WNoxchi/flight-controller/specs/usb-c.md

# Spec: USB-C Interface

## Overview
USB 2.0 Full-Speed device-only (UFP/sink) for DFU flashing and Betaflight configurator.

## Connections
- USB_DM: PA11, USB_DP: PA12
- STM32F405 has internal 1.5kΩ pull-up on D+ (no external needed)

## Circuit
- USB-C connector: 12-pin (HRO TYPE-C-31-M-12), 4 THT mounting tabs + SMD signal pads
- 2x 5.1kΩ resistors on CC1, CC2 to GND (UFP/sink identification)
- ESD protection: USBLC6-2SC6 (ST) dual-line TVS on D+/D-
- 22Ω series resistors on D+ and D- (impedance matching)
- Schottky diode (SS34) from VBUS to 5V rail (power OR with BEC)
- Shield to GND via 1MΩ ∥ 4.7nF

## Assert Constraints
```
# CC1/CC2 sink resistors (USB-C spec requires 5.1k for UFP identification)
assert r_cc1.value within 4.9kohm to 5.3kohm
assert r_cc2.value within 4.9kohm to 5.3kohm

# D+/D- series resistors (USB 2.0 impedance matching)
assert r_dp.value within 20ohm to 24ohm
assert r_dm.value within 20ohm to 24ohm

# VBUS decoupling after Schottky
assert c_vbus.value within 4.0uF to 5.5uF
```

## NDAA
- USBLC6-2SC6: STMicroelectronics (Franco-Italian, clean)
- HRO connector: Korean company (Hroparts Elec, clean)
