WNoxchi/flight-controller/layouts/default/default.kicad_pcb

## KiCad design layouts/default/default.kicad_pcb (2026-03-06)

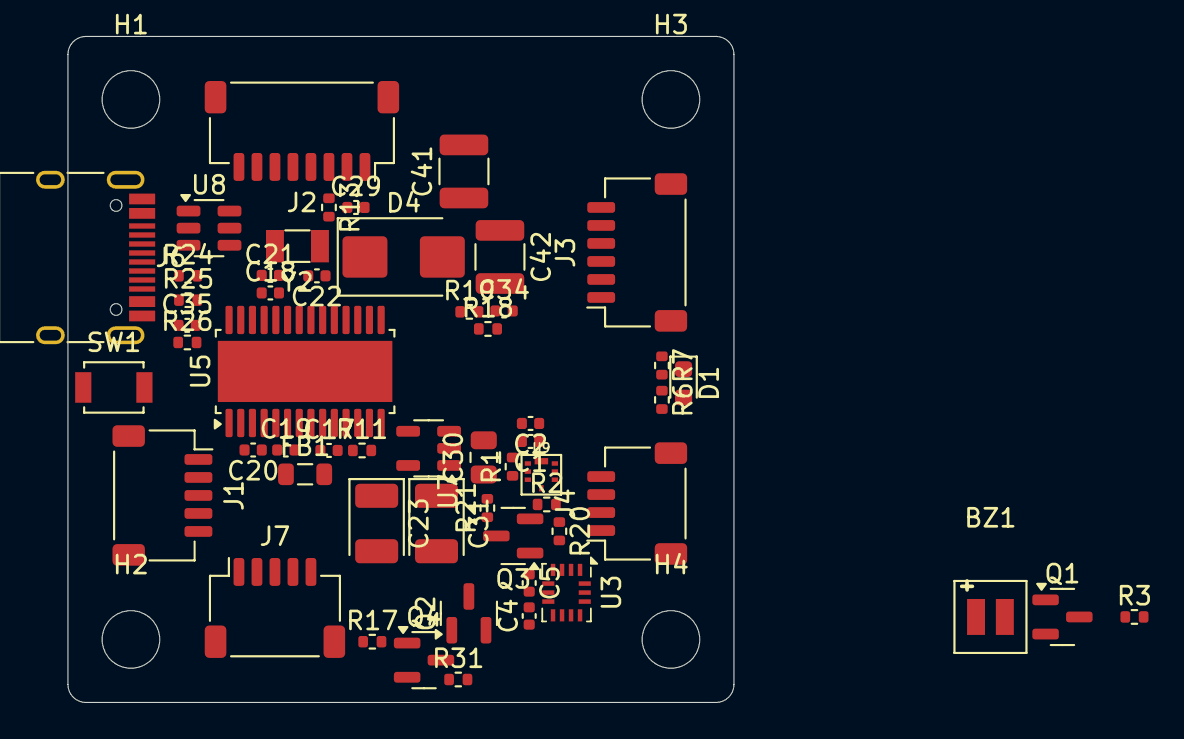
[picture p1: board default.kicad_pcb from above]

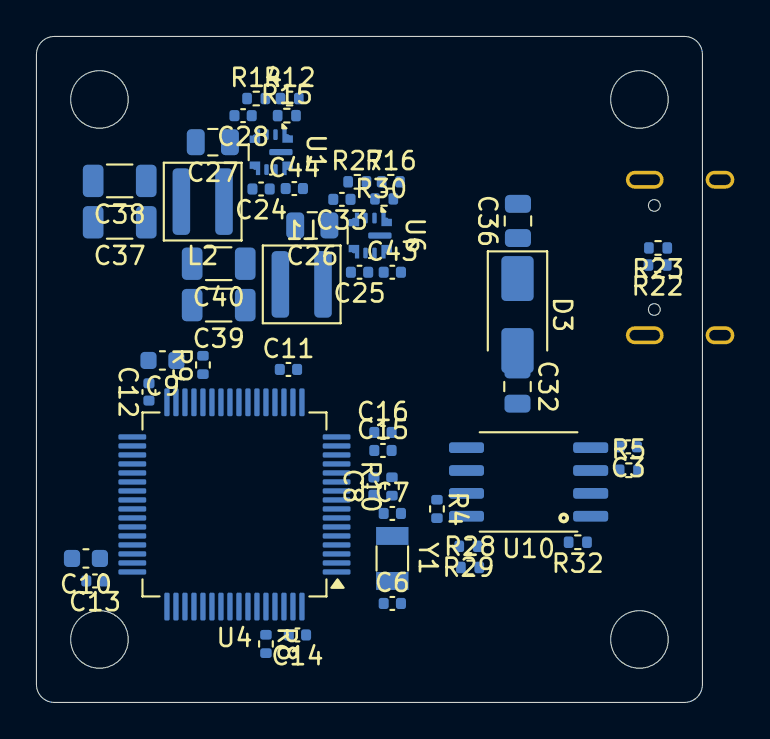
[picture p2: board default.kicad_pcb from below]

Board: 2 copper layers, 37.0 x 37.0 mm, 109 parts (50 on the bottom side), 83 nets, no tracks yet.

Parts:
BZ1: Buzzer_SMD_CMT-4023S_4x4mm
C1, C2, C3, C4, C5, C6, C7, C8, C11, C12, C13, C14, C15, C16, C17, C18, C19, C20, C21, C22, C24, C25, C28, C29, C33, C34, C35, C43, C44: C_0402_1005Metric
C9, C10: C_0603_1608Metric
C23, C31: CP_EIA-3528-21_Kemet-B
C26, C27, C30, C32, C36: C_0805_2012Metric
C37, C38, C39, C40: C_1206_3216Metric
C41, C42: C_1210_3225Metric
D1: LED_0603_1608Metric
D3: D_SMA
D4: D_SMB
FB1: L_0805_2012Metric
H1, H2, H3, H4: MountingHole_3.2mm_M3
J1, J7: JST_SH_SM05B-SRSS-TB_1x05-1MP_P1.00mm_Horizontal
J2: JST_SH_SM08B-SRSS-TB_1x08-1MP_P1.00mm_Horizontal
J3: JST_SH_SM06B-SRSS-TB_1x06-1MP_P1.00mm_Horizontal
J4: JST_SH_SM04B-SRSS-TB_1x04-1MP_P1.00mm_Horizontal
J6: USB_C_Receptacle_HRO_TYPE-C-31-M-12
L1, L2: L_Wuerth_MAPI-4020
Q1, Q2, Q3, Q4: SOT-23
R1, R2, R3, R4, R5, R6, R7, R8, R9, R10, R11, R12, R13, R14, R15, R16, R17, R18, R19, R20, R21, R22, R23, R24, R25, R26, R27, R28, R29, R30, R31, R32: R_0402_1005Metric
SW1: SW_SPST_B3U-1000P
U1, U6: TI_RPE0009B_VQFN-HR-9_2x2mm_P0.5mm
U3: Bosch_LGA-14_3x2.5mm_P0.5mm
U4: LQFP-64_10x10mm_P0.5mm
U5: TSSOP-28-1EP_4.4x9.7mm_P0.65mm_EP3.4x9.7mm_Mask3.1x4.05mm
U7: SOT-23-5
U8: SOT-23-6
U9: Bosch_LGA-10_2x2mm_P0.275x0.250mm
U10: SOIC-8_5.23x5.23mm_P1.27mm
Y1, Y2: Crystal_SMD_3215-2Pin_3.2x1.5mm

Connections:
A5: J6.A5, R22.1
B5: J6.B5, R23.1
adc_curr: C29.1, R13.2, U4.9
adc_vbat: C34.1, R18.1, R19.2, U4.10
anode: D1.2, R6.2
avdd: C17.1, FB1.2, U5.9
baro-gnd: C1.2, C2.2, C3.2, C4.2, C5.2, C17.2, C18.2, C19.2, C21.2, C22.2, C23.2, C26.2, C27.2, C28.2, C29.2, C30.2, C31.2, C32.2, C33.2, C34.2, C35.2, C36.2, C37.2, C38.2, C39.2, C40.2, C41.2, C42.2, C43.2, C44.2, D4.1, J1.1, J1.5, J2.1, J3.1, J4.1, J6.A1, J6.A12, J6.B1, J6.B12, J7.2, Q1.2, Q3.2, Q4.2, R12.2, R16.2, R18.2, R22.2, R23.2, R26.2, R28.2, R32.2, U1.9, U3.6, U3.7, U5.6, U5.10, U5.24, U5.29, U6.1, U6.9, U7.2, U8.3, U9.3, U9.8, U9.9, U10.4
baro-vdd: C1.1, C2.1, C3.1, C4.1, C5.1, C11.1, C12.1, C13.1, C14.1, C15.1, C16.1, C18.1, C19.1, C23.1, C31.1, FB1.1, R1.2, R2.2, R4.2, R5.2, R6.1, R10.2, R11.2, R21.2, SW1.2, U3.5, U3.8, U4.1, U4.13, U4.19, U4.32, U4.48, U4.64, U5.5, U5.25, U7.5, U9.1, U9.5, U9.6, U9.10, U10.8
beeper-drain: BZ1.2, Q1.3
beeper-gate: Q1.1, R3.2
beeper-gpio: R3.1, U4.27
beeper-vdd: BZ1.1, C30.1, C32.1, C39.1, C40.1, D3.2, J1.2, J3.2, J4.2, L1.2, R30.2, U6.8, U7.1, U7.3
boot0: R8.1, SW1.1, U4.60
buck-boot: C25.1, U6.6
buck-en: R16.1, R27.2, U6.3
buck-pgood: R30.1, U6.2
buck-sw: C25.2, L1.1, U6.5
buck-vcc: C43.1, U6.7
buck_vtx-boot: C24.1, U1.6
buck_vtx-en: R12.1, R14.2, U1.3
buck_vtx-pgood: R15.1, U1.2
buck_vtx-sw: C24.2, L2.1, U1.5
buck_vtx-vcc: C44.1, U1.7
c_hse1-gnd: C6.2, C7.2, C8.2, C9.2, C10.2, C11.2, C12.2, C13.2, C14.2, C15.2, C16.2, R8.2, R9.2, U4.12, U4.18, U4.63
c_sag-video_in: C20.2, J7.3, U5.3
cam_conn-video_in: J1.3, U5.8
cam_ctrl: J1.4, U4.55
clkin: C21.1, U5.23, Y2.1
conn-rx-0: J3.4, U4.17
conn-rx-1: J4.3, R20.1
conn-tx-0: J3.3, U4.16
conn-tx-1: J4.4, U4.42
conn-uart_rx: J7.4, U4.54
conn_dm: J6.A7, J6.B7, R24.1, U8.1, U8.2
conn_dp: J6.A6, J6.B6, R25.1, U8.5, U8.6
curr: J2.3, R13.1
data: R7.1, U4.58
dm: R24.2, U4.44
dp: R25.2, U4.45
exti: U3.4, U4.25
fb: R28.1, R29.2, U1.8
flash-cs: U4.59, U10.1
flash-spi_miso: U4.52, U10.2
flash-spi_mosi: U4.57, U10.5
flash-spi_sck: U4.51, U10.6
footprint-cs-0: U3.12, U4.24
footprint-cs-1: U4.33, U5.20
footprint-drain: Q2.1, Q4.3, R31.1
footprint-gate-0: Q4.1, R17.2
footprint-gate-1: Q3.1, R20.2
footprint-gpio-0: D1.1, U4.26
footprint-spi_miso-0: U3.1, U4.22
footprint-spi_miso-1: U4.35, U5.17
footprint-spi_mosi-0: U3.14, U4.23
footprint-spi_mosi-1: U4.36, U5.19
footprint-spi_sck-0: U3.13, U4.21
footprint-spi_sck-1: U4.34, U5.18
footprint-uart_rx: Q3.3, R21.1, U4.43
hold: R4.1, U10.7
nrst: C8.1, R10.1, U4.7
pb2: R9.1, R17.1, U4.28
pc6: J2.4, U4.37
pc7: J2.5, U4.38
pc8: J2.6, U4.39
pc9: J2.7, U4.40
rail_10v_vtx: C37.1, C38.1, L2.2, Q2.2, R15.2, R29.1, R31.2
reset: R11.1, U5.11
rt: R32.1, U1.1
sag: C20.1, U5.4
scl: J3.5, R1.1, U4.61, U9.2
sda: J3.6, R2.1, U4.62, U9.4
shield: C35.1, J6.S1, R26.1
telem: J2.8, U4.15
uart_tx: J7.5, U4.53
vbat: C26.1, C27.1, C28.1, C33.1, C41.1, C42.1, D4.2, J2.2, R14.1, R19.1, R27.1, U1.4, U6.4
vbus: C36.1, D3.1, J6.A4, J6.A9, J6.B4, J6.B9, U8.4
vcap1: C9.1, U4.31
vcap2: C10.1, U4.47
vtx_10v: J7.1, Q2.3
wp: R5.1, U10.3
xfb: C22.1, U5.22, Y2.2
xin: C6.1, U4.5, Y1.1
xout: C7.1, U4.6, Y1.2
