WNoxchi/flight-controller/(commit log)

2026-03-01 TASK-001: Implement MCU core component (STM32F405RGT6)
    Full implementation of the MCU core module with all support circuits:
    - Custom STM32F405RGT6 component definition with verified LQFP-64 pinout
    (64 pins mapped against DS8597 Rev 9 datasheet)
    - 8MHz HSE crystal oscillator (ABM8-8.000MHZ-B2-T) with 20pF load caps
    - VCAP1/VCAP2 internal regulator caps (2.2uF ceramic)
    - Per-VDD decoupling (4x 100nF, one per VDD pin)
    - VDDA analog supply filtering (1uF bulk + 100nF bypass)
    - BOOT0 circuit (10k pulldown + tactile switch to 3.3V for DFU)
    - NRST circuit (10k pullup + 100nF debounce + tactile switch)
    - PB2/BOOT1 mandatory 10k pulldown (SRAM boot trap prevention)
    - SWD debug signals (PA13/PA14)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
2026-03-01 TASK-002: Implement power distribution system (MP1584EN buck + AMS1117 LDO)
    Complete power subsystem with 20 components and 5 passing assertions:
    - MP1584EN SOIC-8 buck converter (VBAT→5V/3A) with feedback divider,
    compensation network, bootstrap cap, inductor, and catch diode
    - AMS1117-3.3 SOT-223 LDO (5V→3.3V) with tantalum output cap
    - VBAT input protection: SMBJ26A TVS + 100uF bulk cap
    - Battery voltage divider: 10k/1k (10:1 ratio) + 100nF filter → PC2
    - Current sense RC filter: 1k + 100nF → PC1
    - PINIO1 P-FET switch: AO3401A with 10k gate resistor for VTX control
    - USB power OR: SS34 Schottky diode + 4.7uF decoupling
    - Bulk decoupling: 100uF on 5V rail, 22uF tantalum on 3.3V r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
2026-03-01 TASK-003: Implement USB-C interface (GCT USB4085-GF-A + USBLC6-2SC6)
    10 components, 5 assert constraints, all passing. Includes:
    - USB4085-GF-A 16-pin connector with alphanumeric pad mapping
    - USBLC6-2SC6 dual-line ESD protection on D+/D-
    - 5.1kohm CC1/CC2 pulldowns for UFP/sink identification
    - 22ohm series resistors on D+/D- for impedance matching
    - 4.7uF VBUS decoupling, 1Mohm||4.7nF shield grounding
    - VBUS wired to power.usb_vbus for power OR circuit
2026-03-01 TASK-004: Implement IMU BMI270 (Bosch LGA-14 + SPI1 decoupling)
2026-03-01 TASK-005: Implement Barometer BMP390 (Bosch LGA-10 + I2C1 bus pullups)
    BMP390 barometric pressure sensor for altitude hold on I2C1 bus:
    - Custom 10-pin component (BST-BMP390-DS002 pinout, LGA-10 2x2mm)
    - I2C mode (CSB=high), address 0x77 (SDO=high), INT unused (polling)
    - VDD + VDDIO 100nF decoupling from 3.3V rail
    - 4.7kΩ I2C bus pullups (shared with GPS magnetometer)
    - 3 VSS pins all grounded, ground wired in tf405.ato
    - 4 assert constraints passing, 27 total assertions, clean ato build
2026-03-01 TASK-007: Implement Flash W25Q128JVSIQ (Winbond SOIC-8 + SPI3 decoupling)
    - W25Q128JVSIQ custom component: 8-pin SOIC-8 mapping from Winbond datasheet
    - /WP and /HOLD pullups (10kohm to VCC) to disable write protection and hold
    - VCC 100nF decoupling capacitor
    - Ground connection (flash.gnd ~ power.gnd) added in tf405.ato
    - 1 assert constraint passing, ato build clean (28 total assertions)
2026-03-01 TASK-009: Wire motor outputs, ESC telemetry, current sense, and power to ESC connector
    - 4x motor outputs: MCU TIM8 CH1-4 (PC6-PC9) → ESC connector M1-M4
    - ESC telemetry: UART4_RX (PA1) → ESC connector TELEM
    - Current sense: ESC CURR → power.curr_in (existing RC filter → PC1 ADC)
    - ESC power: VBAT passthrough + GND from power module
2026-03-01 TASK-010: Wire video signal path (Camera → OSD → VTX + SmartAudio + power)
2026-03-01 TASK-011+012: Wire all UART connectors and implement SBUS inverter
    - SBUS inverter: 2N7002 N-FET common-source inverter with 1kΩ gate resistor
    and 10kΩ drain pullup to 3.3V for SBUS protocol inversion on UART1_RX
    - RX connector (UART1): TX/RX wired via SBUS inverter path to PA9/PA10
    - GPS connector (UART2+I2C1): TX/RX to PA2/PA3, SCL/SDA to PB8/PB9
    - Spare connector (UART3): TX/RX to PB10/PB11
    - All connector power (5V) and ground connections added
    - All misc module grounds connected (LED, beeper, LED strip, camera control)
    - 32 assertions passing, 78 components in BOM, clean ato build
2026-03-01 TASK-013: Implement Status LED (active-low green 0603 + 1kΩ resistor)
2026-03-01 TASK-014: Implement Beeper Circuit (MLT-8530 + 2N7002 N-FET low-side driver)
    - MLT-8530 SMD passive piezo buzzer (8.5mm, 80dB SPL, LCSC C94599)
    - 2N7002 N-FET low-side switch: 5V → buzzer → FET drain → GND
    - 10kΩ gate resistor (limits inrush, ESD protection)
    - Betaflight BEEPER_INVERTED=ON: PB1 high → FET on → buzzer sounds
    - 34 assertions passing, 83 components in BOM
2026-03-01 TASK-015: Implement LED Strip Output (330Ω series resistor on WS2812 data line)
2026-03-01 TASK-016: Implement Camera Control Output (PB3 solder pad breakout)
    Direct GPIO passthrough from PB3 to solder pad for Betaflight camera
    OSD joystick emulation. No passive components needed — camera input
    is high-impedance. All 35 assertions still passing, clean ato build.
2026-03-01 TASK-017: Implement PA4 servo/detonator solder pad breakout
    PA4 (DAC_OUT1 / TIM2_CH1) broken out to solder pad via PA4Breakout
    module in misc.ato. Direct GPIO-to-pad passthrough, no passive
    components needed. Wired in tf405.ato with ground connection.
    All circuit implementation tasks now complete (TASK-001 through TASK-018).
2026-03-01 TASK-011A: Fix SpareConnector 6-pin definition with duplicate power/ground pins
    Add v5_2 and gnd_2 signals to SpareConnector module to match the spec's
    6-pin JST-SH pinout: GND(1), 5V(2), TX3(3), RX3(4), 5V(5), GND(6).
    Duplicate power/ground pins provide higher current capacity and lower
    impedance return path. Also marks TASK-019 complete (35/35 feasible
    asserts already implemented; 9 voltage-level asserts not possible in
    atopile v0.2.69).
2026-03-01 TASK-020: Define PCB layer stackup specification
    4-layer stackup (Sig/GND/PWR/Sig) targeting JLCPCB standard process:
    - 1oz outer / 0.5oz inner copper, 1.6mm total, 2116 prepreg
    - USB 2.0: 90Ω differential (0.20mm/0.15mm gap microstrip)
    - Video: 75Ω single-ended (0.30mm microstrip)
    - Power trace sizing, via specs, DRC rules, placement guidelines
    - Impedance calculations verified against stackup dimensions
2026-03-01 TASK-021: Define physical board constraints and mechanical specification
    Create specs/board-mechanical.md with complete physical constraints for PCB layout:
    - 36x36mm board outline with 1mm corner radii and Edge.Cuts coordinates for KiCad
    - 30.5x30.5mm M3 mounting pattern with exact hole coordinates and 7mm keep-out zones
    - Component height restrictions by zone (top side 2-8mm, bottom side 0-1.5mm)
    - Connector edge assignment map (rear=ESC/RX/USB, left=GPS/Spare, right=VTX/Camera)
    - Solder pad placement for SWD debug, GPIO breakouts, and SBUS selection jumper
    - Keep-out zones for mounting holes, IMU isolation, baro thermal isolation, buck converter
    - Fiducial marks, silkscreen markings, and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
2026-03-01 TASK-022: Create comprehensive weight budget document
    Add WEIGHT_BUDGET.md with complete BOM mass analysis:
    - 92 components cataloged with masses from datasheets/LCSC data
    - Bare PCB: 3.7g, components: 3.84g, solder: 0.10g = 7.6g total
    - Within 8g target with 0.4g margin (5% under)
    - Actual LCSC parts from ato build solver output used
    - Identified voltage rating issue: C1 (VBAT bulk 100uF) resolved
    to 6.3V tantalum — needs manual override to 50V during layout
    All 23 implementation tasks now complete. Project ready for PCB layout.
2026-03-01 Fix VBAT cap voltage ratings and add revisions tracker
    Pin specific 35V-rated MPNs on the two VBAT-rail capacitors (c_vbat_bulk
    and c_buck_in) — the generic solver picked a 6.3V tantalum for the bulk
    cap, which would fail on a 6S input (25.2V). Add warning on generic
    ElectrolyticCap to prevent reuse on high-voltage rails.
    Add revisions.md documenting known divergences from Brave F7 reference
    (MCU, voltage range, BEC topology) and future work items (JST connectors,
    ESC telemetry UART assignment).
2026-03-01 REV-001: Add physical JST-SH connectors and fix footprint library prefixes
    Define JST-SH 1.0mm SMD connector components (3/4/6/8 pin) with
    KiCad footprints and MPNs (SM0xB-SRSS-TB). Each connector module
    now instantiates a physical component with pin-to-signal mapping.
    Also fixes pre-existing build issues:
    - Add KiCad library prefixes to all footprints (Package_QFP:,
    Connector_JST:, etc.) so atopile can resolve them
    - Add fp-lib-table from KiCad 9 for footprint library resolution
    - Create lib.pretty with BMP390 custom footprint stub
    - Rename baro signal 'int' to 'int_out' (reserved keyword)
    Connector pinouts per fc405-pinmap-spec.md:
    - ESC: 8-pin (GND/VBAT/CURR/M1-M4/TELEM)
    - RX: 4-pin (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
2026-03-01 REV-004: Fix all footprint references — ato build passes
    Resolve all 4 missing footprints so `ato build` completes successfully:
    - CP_Elec_6.3x7.7mm → CP_Elec_6.3x7.7 (dropped erroneous "mm" suffix)
    - TSSOP-28-1EP → use full KiCad name with EP dimensions (AT7456E)
    - SOIC-8_5.23x5.23mm (W25Q128 208mil) → custom footprint in lib.pretty
    - Buzzer_SMD_MLT-8530_8.5x8.5mm → custom footprint in lib.pretty
    Also fix fp-lib-table to use absolute paths instead of unresolved
    ${KICAD9_FOOTPRINT_DIR} variable (atopile doesn't resolve KiCad
    internal env vars).
    Build result: all design checks pass, PCB updated, BOM/netlist generated.
    [default.kicad_pcb]
2026-03-01 REV-005: Add footprints to all passive components — 91 parts now in KiCad PCB
    Generic Resistor and Capacitor components had no footprint assignments,
    causing 62 components to be excluded from the PCB netlist. Fixed by:
    - Added default 0402 footprints to Resistor and Capacitor components
    - Overrode to 0603 for VCAP 2.2uF caps, 0805 for 4.7-10uF, 1206 for 22uF
    - Replaced generic ElectrolyticCap (no footprint) with pinned components:
    c_5v_bulk reuses Cap_100uF_35V, c_3v3_bulk/c_ldo_out use new
    Cap_22uF_10V_Tant (EIA-3528 Kemet-B tantalum for AMS1117 ESR stability)
    [default.kicad_pcb]
2026-03-02 REV-007: Add 10V VTX BEC and upgrade VTX connector to 5-pin
    Add dedicated 10V/2A MP1584EN buck converter for VTX power, matching the
    Brave F7 reference design. Upgrade VTX connector from 4-pin to 5-pin JST-SH
    with full UART5 (TX+RX) for bidirectional VTX control (IRC Tramp, SmartAudio
    v2.1). Redesign PINIO1 with 2N7002 N-FET level shifter for proper P-FET gate
    drive at 10V source. Fix pre-existing duplicate REF** designators in PCB.
    [default.kicad_pcb]
2026-03-02 REV-008: Replace cylindrical electrolytics with flat MLCCs
    Remove all tall cylindrical aluminum electrolytic capacitors to match Brave F7
    flat profile. VBAT bulk: 1x 100uF/35V electrolytic → 2x 22uF/35V MLCC (1210).
    5V bulk: 1x 100uF/35V electrolytic → 2x 22uF/16V MLCC (1206). Removed unused
    Cap_100uF_35V component definition.
    [default.kicad_pcb]
2026-03-02 REV-008: Single smaller boot button — Omron B3U-1000P replaces dual TL3342
    Remove dedicated NRST button, replace BOOT0 button with compact Omron B3U-1000P
    (3.0x2.5mm) to match Brave F7 reference. NRST pullup and debounce cap retained.
    Saves ~0.21g, frees board space.
    [default.kicad_pcb]
2026-03-02 Add persistent M3 mounting holes to ato source
    Define MountingHole_M3 component (NPTH, no pad, no electrical connection)
    matching Brave F7 reference. Four instances (H1-H4) in tf405.ato survive
    ato build instead of being stripped from the PCB.
    [default.kicad_pcb]
2026-03-02 Resize board to 37x37mm with 30x30mm mounting pattern
    Match Brave F7 reference dimensions. Board outline expanded from 36mm to
    37mm in KiCad PCB. Mounting holes updated to 30x30mm pattern (3.5mm edge
    offset). Specs, weight budget, and comments updated accordingly.
    [default.kicad_pcb]
2026-03-02 Unhide all reference designators on PCB silkscreen
    Make all 95 component reference designators (Y2, U3, R14, etc.) visible
    on F.SilkS layer for easier identification during layout and review.
    [default.kicad_pcb]
2026-03-04 REV-009: Replace MP1584EN with TI LMR43620 for NDAA compliance
    Switch both buck converters from MPS MP1584EN (SOIC-8, asynchronous) to
    TI LMR43620 (VQFN-HR 2x2mm, synchronous, internally compensated).
    5V BEC uses fixed-output LMR43620MB5RPER; 10V VTX BEC uses adjustable
    LMR43620RNXTRPER with 90.9k/10k FB divider (VREF=1.0V).
    Removes external Schottky catch diodes, compensation networks, and 5V
    feedback divider. Adds VCC bypass caps, VIN HF bypass caps, and custom
    13-pad VQFN-HR footprint with L-shaped corner pads.
    [default.kicad_pcb]
2026-03-04 REV-009b: Align buck design with Brave F7 dual-5V topology
    Both bucks now use LMR43620MB5RPER (fixed 5V) matching the Brave F7
    reference board (both marked "2MB5"). Second buck provides dedicated
    clean 5V for VTX instead of 10V — removes RT resistor, FB divider.
    Additional changes:
    - Add EN/UVLO dividers (430k/100k) on both bucks for production-grade
    under-voltage lockout at ~6.5V rising
    - Add PGOOD pullup resistors (100k) on both bucks
    - Switch inductors from 4.7uH/6.3mm to 2.2uH/4mm (Wuerth MAPI-4020)
    matching TI 1MHz recommendation and Brave F7 inductor specs
    - Unhide all reference designators on PCB silkscreen
    [default.kicad_pcb]
2026-03-04 Update specs and revisions to reflect REV-009b dual-5V topology
    Specs still referenced the 10V adjustable VTX BEC (LMR43620RNXTRPER)
    and old 4.7µH inductors. Updated power, video, board-constraints specs
    and revision history to match the current dual-5V design with EN/UVLO
    dividers, PGOOD pullups, and 2.2µH inductors.
2026-03-04 Update layout checklist: mark Groups 4 & 5 placed, fix designators
    Replace placeholder names (C_5V_IN, etc.) with actual designators from
    netlist (C26, C33, etc.). Update Group 5 from obsolete 10V adjustable
    to 5V fixed variant per REV-009b.
2026-03-04 Replace USB-C connector with HRO TYPE-C-31-M-12
    Swap GCT USB4085-GF-A (16-pin full SMD) for HRO TYPE-C-31-M-12
    (12-pin, 4 THT mounting tabs + SMD signal pads) to match Brave F7
    form factor. Identical pin names — no wiring changes needed.
    Unhide all reference designators on PCB silkscreen.
    [default.kicad_pcb]
2026-03-04 Update tantalum caps from 22µF to 47µF to match Brave F7
    C31 (LDO output) and C23 (3.3V bulk) changed from TAJB226K010RNJ
    to TAJB476K010RNJ. Same Case B footprint. Marking "476A" matches
    Brave F7 reference board. Also marks Groups 2 and 3 as placed.
    [default.kicad_pcb]
2026-03-04 Replace AMS1117 with TI TLV75533 LDO, SS34 with SS54 Schottky
    AMS1117 is Chinese (AMS, Shenzhen) — not NDAA compliant. TLV75533
    is TI (SOT-23-5, 500mA, stable with MLCC). EN tied to VIN. SS54
    is a drop-in 5A upgrade over SS34 (same SMA footprint). Both match
    Brave F7 reference board components.
    [default.kicad_pcb]
2026-03-04 Revert VTX BEC from fixed 5V to adjustable 10V (REV-010)
    Brave F7 reference outputs 10V on its VTX connector, not 5V.
    VTX buck changed from LMR43620MB5RPER (fixed) to LMR43620RNXTRPER
    (adjustable) with 13kΩ RT resistor and 90.9kΩ/10kΩ FB divider
    for 10.09V output. PINIO1 P-FET switch updated for 10V rail.
    [default.kicad_pcb]
2026-03-06 Replace MLT-8530 buzzer with Same Sky CMT-4023S (NDAA, 78% smaller)
    MLT-8530 (8.5x8.5mm, Chinese) replaced with CMT-4023S-SMT-TR
    (4x4x2mm, Same Sky/CUI, US-headquartered, NDAA-compliant).
    70dB vs 80dB SPL trade-off for 78% area reduction. Custom KiCad
    footprint created. Also removed spare connector (J5) — UART3
    will route to solder pads at board perimeter. Layout clusters
    reorganized for remaining component placement.
    [default.kicad_pcb]
2026-10-18 Ignore generated KiCad and atopile state
